plushugh/hall2040/hall2040.kicad_pcb

## KiCad design hall2040.kicad_pcb (2024-03-05)

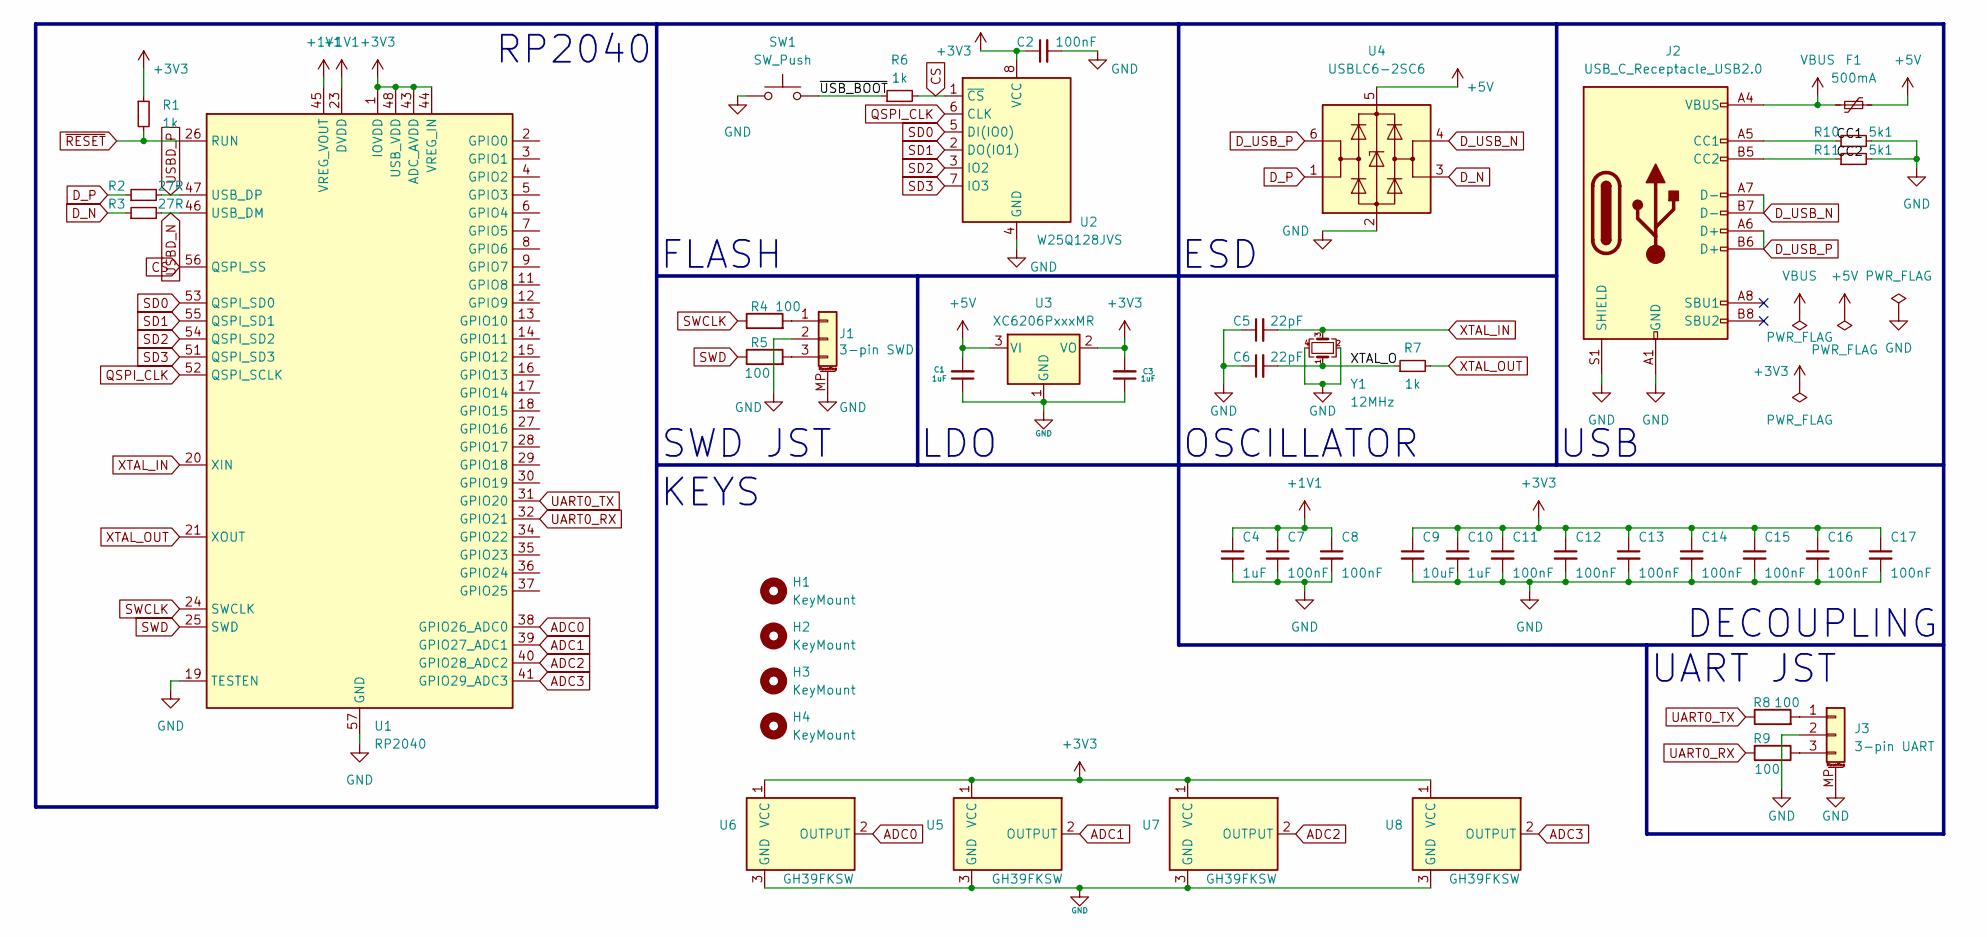
[picture p1: schematic hall2040.kicad_sch]

Parts:
C1, C3, C4, C10: 1uF; C_0402_1005Metric; LCSC C52923
C2, C7, C8, C11, C12, C13, C14, C15, C16, C17: 100nF; C_0402_1005Metric; LCSC C1525
C5, C6: 22pF; C_0402_1005Metric; LCSC C1555
C9: 10uF; C_0402_1005Metric; LCSC C15525
F1: 500mA; Fuse_1206_3216Metric; LCSC C70076
H1, H2, H3, H4: KeyMount; SW_Cherry_MX_PCB
J1: 3-pin SWD; JST_SH_BM03B-SRSS-TB_1x03-1MP_P1.00mm_Vertical
J2: USB_C_Receptacle_USB2.0; USB_C_Receptacle_HRO_TYPE-C-31-M-12; LCSC C165948
J3: 3-pin UART; JST_SH_BM03B-SRSS-TB_1x03-1MP_P1.00mm_Vertical
R1, R6, R7: 1k; R_0402_1005Metric; LCSC C11702
R2, R3: 27R; R_0603_1608Metric; LCSC C25190
R4, R5, R8, R9: 100; R_0603_1608Metric
R10, R11: 5k1; R_0402_1005Metric; LCSC C25905
SW1: SW_Push; SW_SPST_PTS810; LCSC C221896
U1: RP2040; QFN-56-1EP_7x7mm_P0.4mm_EP3.2x3.2mm; LCSC C2040
U2: W25Q128JVS; SOIC-8_5.23x5.23mm_P1.27mm; LCSC C131025
U3: XC6206PxxxMR; SOT-23-3; LCSC C5250982
U4: USBLC6-2SC6; SOT-23-6; LCSC C2827654
U5, U6, U7, U8: GH39FKSW; SOT-23; LCSC C266230
Y1: 12MHz; Crystal_SMD_3225-4Pin_3.2x2.5mm; LCSC C9002

Connections:
+1V1: C4.1, C7.1, C8.1, U1.23 (DVDD), U1.45 (VREG_VOUT), U1.50 (DVDD)
+3V3: C2.1, C3.2, C9.1, C10.1, C11.1, C12.1, C13.1, C14.1, C15.1, C16.1, C17.1, R1.1, U1.1 (IOVDD), U1.10 (IOVDD), U1.22 (IOVDD), U1.33 (IOVDD), U1.42 (IOVDD), U1.43 (ADC_AVDD), U1.44 (VREG_IN), U1.48 (USB_VDD), U1.49 (IOVDD), U2.8 (VCC), U3.2 (VO), U5.1 (VCC), U6.1 (VCC), U7.1 (VCC), U8.1 (VCC)
+5V: C1.2, F1.2, U3.3 (VI), U4.5 (VBUS)
/CC1: J2.A5 (CC1), R10.1
/CC2: J2.B5 (CC2), R11.1
/XTAL_O: C6.2, R7.1, Y1.1
/~USB_BOOT: R6.1, SW1.2
ADC0: U1.38 (GPIO26_ADC0), U6.2 (OUTPUT)
ADC1: U1.39 (GPIO27_ADC1), U5.2 (OUTPUT)
ADC2: U1.40 (GPIO28_ADC2), U7.2 (OUTPUT)
ADC3: U1.41 (GPIO29_ADC3), U8.2 (OUTPUT)
CS: R6.2, U1.56 (QSPI_SS), U2.1 (~CS)
D_N: R3.1, U4.3 (I/O2)
D_P: R2.1, U4.1 (I/O1)
D_USB_N: J2.A7 (D-), J2.B7 (D-), U4.4 (I/O2)
D_USB_P: J2.A6 (D+), J2.B6 (D+), U4.6 (I/O1)
GND: C1.1, C2.2, C3.1, C4.2, C5.1, C6.1, C7.2, C8.2, C9.2, C10.2, C11.2, C12.2, C13.2, C14.2, C15.2, C16.2, C17.2, J1.2, J1.MP (MountPin), J2.A1 (GND), J2.A12 (GND), J2.B1 (GND), J2.B12 (GND), J2.S1 (SHIELD), J3.2, J3.MP (MountPin), R10.2, R11.2, SW1.1, U1.19 (TESTEN), U1.57 (GND), U2.4 (GND), U3.1 (GND), U4.2 (GND), U5.3 (GND), U6.3 (GND), U7.3 (GND), U8.3 (GND), Y1.2, Y1.4
unnamed: J1.1, R4.2
unnamed: J1.3, R5.2
unnamed: J3.1, R8.2
unnamed: J3.3, R9.1
QSPI_CLK: U1.52 (QSPI_SCLK), U2.6 (CLK)
SD0: U1.53 (QSPI_SD0), U2.5 (DI(IO0))
SD1: U1.55 (QSPI_SD1), U2.2 (DO(IO1))
SD2: U1.54 (QSPI_SD2), U2.3 (IO2)
SD3: U1.51 (QSPI_SD3), U2.7 (IO3)
SWCLK: R4.1, U1.24 (SWCLK)
SWD: R5.1, U1.25 (SWD)
UART0_RX: R9.2, U1.32 (GPIO21)
UART0_TX: R8.1, U1.31 (GPIO20)
USBD_N: R3.2, U1.46 (USB_DM)
USBD_P: R2.2, U1.47 (USB_DP)
VBUS: F1.1, J2.A4 (VBUS), J2.A9 (VBUS), J2.B4 (VBUS), J2.B9 (VBUS)
XTAL_IN: C5.2, U1.20 (XIN), Y1.3
XTAL_OUT: R7.2, U1.21 (XOUT)
~RESET: R1.2, U1.26 (RUN)

Notes on the sheet:
RP2040
OSCILLATOR
ESD
UART JST
DECOUPLING
KEYS
SWD JST
USB
LDO
FLASH

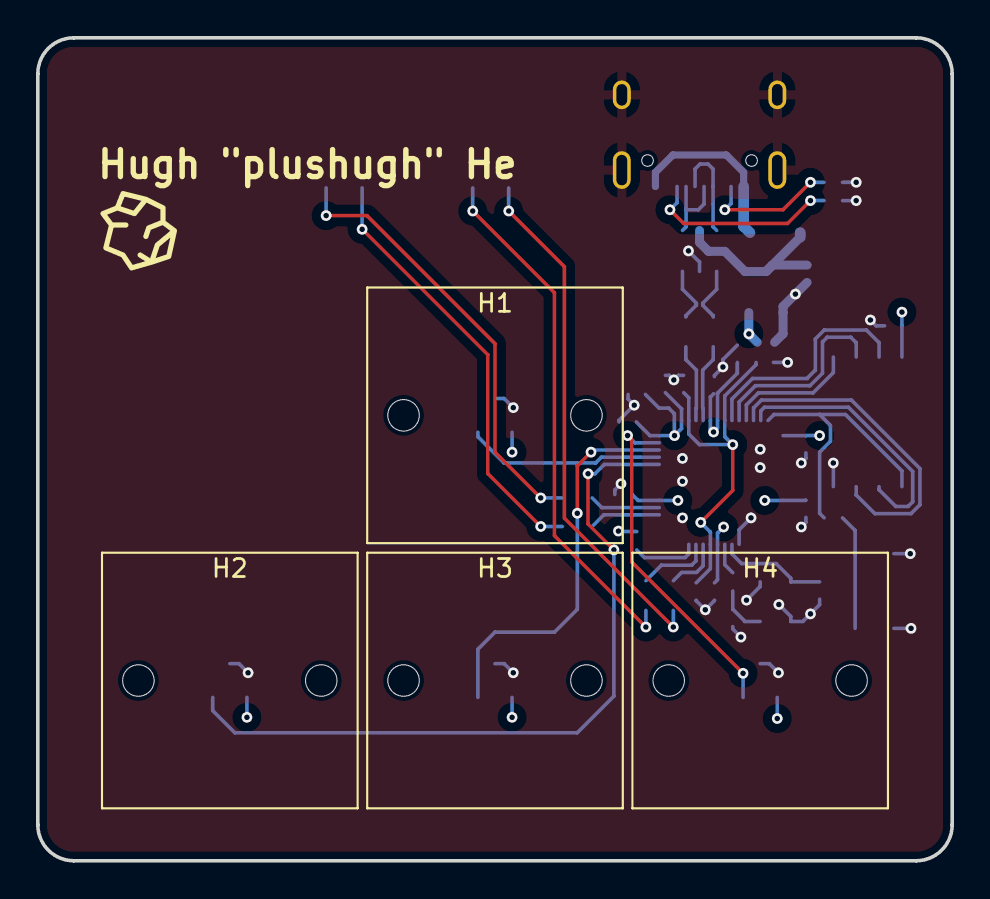
[picture p2: board hall2040.kicad_pcb from above]

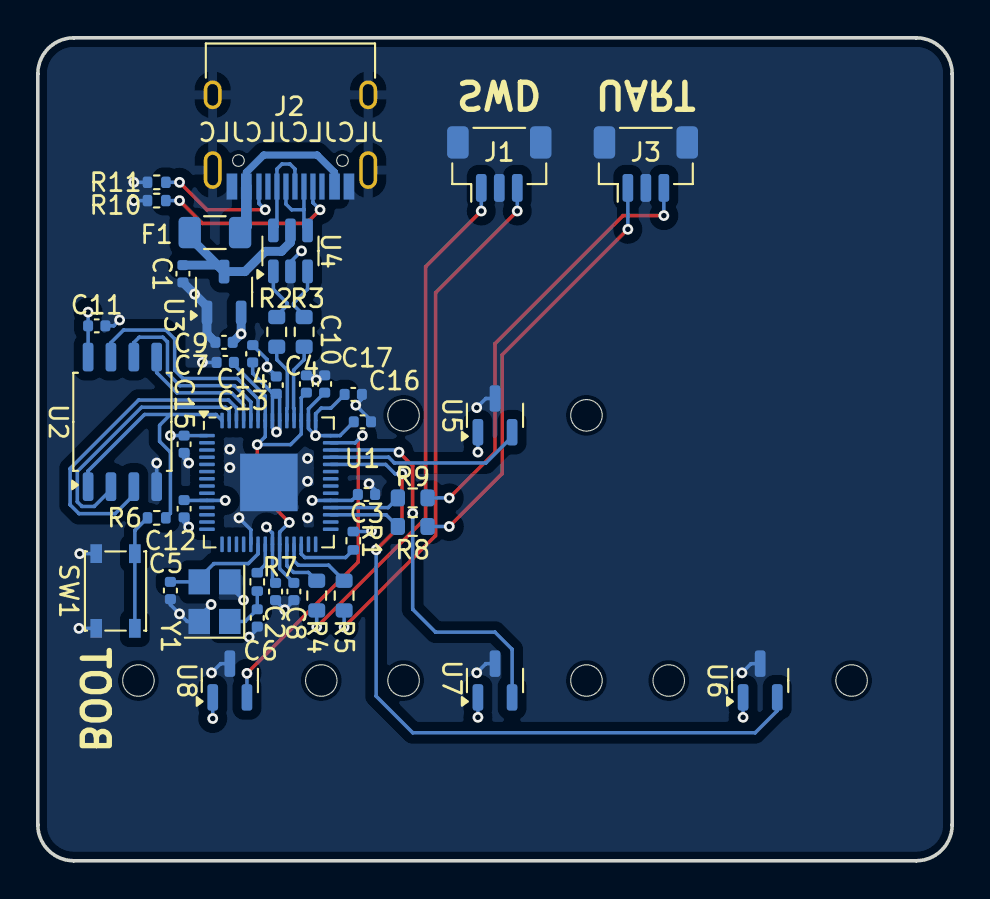
[picture p3: board hall2040.kicad_pcb from below]

Board: 4 copper layers, 50.8 x 45.7 mm, 46 parts (42 on the bottom side), 36 nets.
